matthewesses/ECE445_Team2_LabNotebooks/Notebooks/Shreya_Venkat/unnamed.jpeg

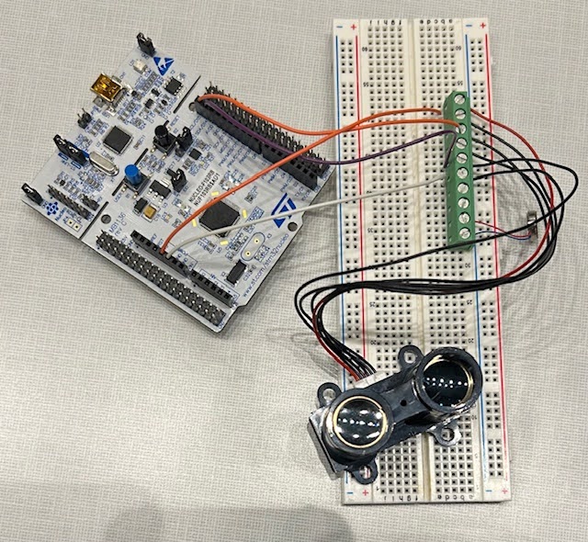
Notebooks/Shreya_Venkat/unnamed.jpeg
