matthewesses/ECE445_Team2_LabNotebooks/README.md

# ECE445 Team 2's Lab Notebooks
Lab Notebook repository for Team 2 for ECE 445 at UIUC
