matthewesses/ECE445_Team2_LabNotebooks/Boards/Initial Schematics/readme.txt

These schematics were the initial ones created by Varik and Matt
They contain (almost) every part that needs to be in the project in some capacity.
The voltage divider resistors that should be on the hall effect sensors are not here (yet).
