matthewesses/ECE445_Team2_LabNotebooks/Notebooks/Matthew_Esses/readme.md

# Engineering notebook

## 1/14-1/15 Project Ideation and Concept Development

### Initial Discussion with Mitchell
Before the class officially began, Mitchell and I discussed the primary aim of our project. We considered various factors such as the project's usefulness, the problem space it addresses, and the need for it to be enjoyable to work on.

### Exploration of Project Ideas
- **Remote Sensing Systems:** We both shared an interest in working with remote sensing systems like RaDAR and LiDAR.
- **Nintendo Switch JoyCon IR Camera Sensors:** Initially, I considered reverse engineering the Nintendo Switch JoyCon IR Camera Sensors for a wearable LiDAR system. However, due to challenges such as poor documentation, legal and ethical concerns, and the non-traditional problem space, this idea was abandoned.
- **ECE 445 Documentation Review:** Upon reviewing the documentation on the ECE 445 page, I realized the importance of the project being useful to someone, which led to a shift in focus.

### Final Project Concept: Wearable LiDAR for the Blind
- **LiDAR Principle:** LiDAR technology requires radial movement to generate a point cloud.
- **Initial Design Concept:**
  - Utilized a ring gear driven by two stepper motors.
  - Integrated LiDAR sensors into the ring gear, communicating wirelessly with a main computing unit.
- **Challenges and Abandonment:**
  - Power consumption concerns.
  - Feasibility issues.
  - Potential user discomfort.
  - Lack of practical usefulness.

### Conceptual Diagram
Wearable LiDAR Concept

## Engineering Notebook Entry - 1/16

### Inspiration from Natural Design
- **Radial Movement Concept:** Inspired by the arrangement of eyes on creatures' heads rather than their necks, I drew inspiration from propeller hats to achieve radial movement for the LiDAR system alongside a slip-ring.

### Sensor Range Consideration
- **NIR Range Selection:** Opted to develop a LiDAR sensor within the Near-Infrared (NIR) range instead of using an off-the-shelf solution. The choice was influenced by NIR's reduced vulnerability to solar noise due to the absorption properties of molecular oxygen and water vapor.

### Atmospheric Absorption Analysis
- **Reference [1]:** Explained the absorption of light by molecular oxygen and water vapor in the red, near-infrared, and mid-infrared regions.

Figure 3: Light Absorption Via the Atmosphere

### Collaboration and Guidance
- **Office Hours with Jason (Head Lab TA):** Discussed the project requirements for building a LiDAR sensor using a time-of-flight ASIC.
- **Recommendations:**
  - Use of the STM32F401 microcontroller.
  - Integration of a Hall Effect sensor to determine motor orientation and track RPM of the sensor motor.
- **Concept Sketch:** Provided a rough sketch of the sensor concept.

Concept Sketch

## 1/17

### Sensor Selection and Additional Features
- **Design Feasibility:** After discussions with professors, it was determined that designing our own sensor was not feasible, leading us to opt for an off-the-shelf solution.
- **Incorporation of Doppler Radar:** To enhance functionality, a Doppler Radar was added to provide data below eye-level, particularly for emergency collision prevention purposes.

### Project Research and Documentation
- **Review of Previous Projects:** Studied projects from previous years to gain insights and inspiration.
- **Faculty Consultations:** Addressed questions from professors to ensure project alignment and feasibility.
- **Submission of RFA:** Submitted the Request for Approval (RFA) after completing a rough sketch of the physical design, which was shared with the team.

### Design Enhancement and Communication
- **Physical Design Sketch:** Shared a rough sketch of the physical design with the team, detailing key components and layout.
- **CAD Modeling:** Created a professional CAD model for the design, documented in the design document.

### Functional Enhancements
- **Motor Intensity Control:** Planned to implement motor intensity control using haptic feedback and Pulse Width Modulation (PWM) techniques for enhanced user interaction.

## 1/18

### Meeting with team for first time
- Met with team for the first time on 1/18, explained more of the ideas verbally, got feedback, planned roles and ways forward

## 1/24

### LiDAR Sensor Testing
- **Data Acquisition:** Focused on obtaining readings from the LiDAR sensor.
- **Datasheet Reference:** Utilized a datasheet for the LiDAR sensor available within the class resources.
- **Team Collaboration:** Tested the LiDAR sensor on an Arduino development board as a team, verifying its accuracy and performance against the datasheet specifications.

### Exploration of Hall Effect Sensors
- **Research and Learning:** Delved into understanding the functionality of Hall Effect sensors.
- **Initial Progress:** Began designing a Hall Effect sensor array to determine the orientation of the LiDAR sensor and synchronize it with the haptic feedback motors.

### Productivity Challenges
- **Personal Impact:** Experienced a period of decreased productivity for several weeks going forward due to personal reasons.

### Ongoing Development
- **Hall Effect Sensor Array Design:** Continued work on designing the Hall Effect sensor array for angle detection of the LiDAR sensor and its integration with the haptic feedback motors.

### Next Steps
- **Resume Development:** Plan to resume full development activities and focus on completing the Hall Effect sensor array design and synchronization with motor control for the LiDAR system.

##  Death of DeMux 2/5

### DeMux death
- **Demultiplexer no longer used:** Partner Mitchell was strongly convinced using a demultiplexer to run PDM to a motor and using an ATMEGA328 was not viable and could not work. I strongly disagreed, but let it go because I was experiencing bad personal circumstances. Edit 4/29: in hindsight, terrible decision to let this go, partner Shreya took my side on this and it likely would have made the entire project more successful and we would have had next to no problems in programming due to more reliable documentation and course staff assistance for the ATMEGA. There were never any sources to back up the claim of it not working for the proposed design, but I digress.

## 2/12/24 Meeting 1 with Sanjana TA
### What was accomplished
- **Given Locker**
- **Able to order parts**
- **ordered parts**

## 2/19/24 Meeting 2 with Sanjana TA
### What was accomplished
- **Discussed design progress and BOM**

## 2/26/24 Meeting 3 with Sanjana TA
### What was accomplished
- **Meeting cancelled**

## 3/4 Meeting 4 with Sanjana TA
### What was accomplished
- **we need to work on the CAD, last TA meeting of note before 3/25**

## STM32F401 Programming and PCB Routing - 3/6-3/13

### STM32F401 Programming
- **Learning Phase:** Acquired knowledge for programming the STM32F401 microcontroller.
- **Circuit Enhancements:** Added an SWD header and Micro-USB connector to the circuit diagram for enhanced connectivity and programming capabilities.

### PCB Routing
- **Responsibility Assignment:** Took on the task of routing the PCB for the project.
- **Layer Consideration:** Ensured that reworking the microcontroller connections allowed for efficient routing on two layers.

### Team Collaboration and Quality Control
- **PCB Review:** Checked and verified the PCB design for any design violations, collaborating with team members Mitchell and Shreya.
- **Ordering Process:** Assisted in the order placement for the PCB board, handled by team member Shreya.

### Current Progress and Next Steps
- **Ongoing Work:** Waiting for completion of I2C integration with the STM32 dev board by Shreya to proceed with further physical design work.
- **Control Flow Mapping:** Mapped out the control flow for the control unit's programming, ensuring a clear understanding of the system's functionality.
- **Upcoming Tasks:** Deciding on off-board components for the half-wave rectifier and voltage divider for the Hall Effect sensors, focusing on low power consumption considerations.

### Pictures of circuit CAD
Pictures of circuit CAD


## 3/25 Meeting 5 with Sanjana TA
### What was accomplished
- **motioned to move accelerometer and we plan testing**

## 3/14-4/05 WAITING FOR THE PCB!!!

The PCB took a very long time to arrive. We decided on using either a stepper motor or the motor from ECE 110 at this time.

## 4/1 Meeting 6 with Sanjana TA
### What was accomplished
- **find back-up plans for if stuff does not work**

## 4/4 New scanning mechanism

### **Current Progress and Next Steps:** gave up on waiting and redesigned the drive train to be belt driven instead of purely gear driven to make the Hall-Effect module feasible. 3D printing first parts

# Engineering Notebook Entry - 4/7-4/10

## PCB Arrival and Troubleshooting

### PCB Delivery and Initial Issues
- **PCB Arrival:** Received the PCBs today.
- **Short Circuit Discovery:** Identified a short circuit between specific pins on the PCB.

### Troubleshooting and Resolution
- **Responsibility:** Tasked with locating and eliminating the short circuit to ensure proper board functionality.
- **Problem Areas:** Narrowed down potential locations of the short circuit to boot1 and boot0 pins, along with the 3V line connected to the buck converters.
- **Attempted non-destructive testing** Tried using a Nintendo switch joycon as an IR camera to read where the short was when I ran like 6W through the board, and it kinda went terribly and didnt show much due to the incident light was the only IR
- **Resolution Approach:** Drilled small holes into the PCB to pinpoint and eliminate the short circuit.
- **Success and Board Functionality:** After drilling, the board functioned as expected, allowing for continued progress and programming.

### Workload and Persistence
- **Time Investment:** Spent an entire night drilling into the boards to accurately identify and resolve the short circuit by myself.
- **Purpose of Drilling:** Ensured that the board could still be programmed and utilized for further iterations, even if similar issues were encountered in subsequent versions. I was also able to add destructive testing to my resume.

## Images of Drilled PCBs
- Drilled PCB 1
- Drilled PCB 2
- Drilled PCB 3

## Board Replacement and Progress - 4/11-4/13

### New Board Arrival
- **Replacement Boards:** Received the new set of boards, which did not have the short circuit issue found in the previous batch. Made final iteration of board and made sure they passed DRC.

### Personal Break and Decompression
- **Time Off:** Took a few days off to decompress and relax after the challenging experience of destructive testing being completely pointless. Did other coursework.

### Team Progress
- **Board Functionality:** The team successfully managed to get the new boards recognized by the development board and initiated programming tasks.

### Note on Progress
- **Alleged Programming Success:** While programming was reportedly successful, further verification and testing may be required to confirm full functionality and reliability.

## Drive Train and Scanning Mechanism Redesign -4/14-4/16

### Redesign Process
- **Drive Train and Scanning Mechanism:** Undertook another redesign iteration for improved functionality and performance. Group said part of it was too short.
- **3D Printing and Machining:** Utilized both 3D printing and manual machining through wood by hand drilling to create the redesigned components. Team lost access to MEB due to accidentally leaving a hot glue gun on.

### Hall Effect Module Holder Design
- **Design Task:** Created a holder specifically designed to accommodate the Hall Effect module, ensuring proper positioning and functionality within the system. 

### Progress Update
- **Completed Tasks:** Successfully completed the redesign of the drive train/scanning mechanism and the design of the Hall Effect module holder. completely assembled all parts.

### Next Steps
- **Integration:** Proceed with integrating the redesigned components into the overall system.
- **Testing:** Conduct initial testing to evaluate the performance and functionality of the redesigned drive train and scanning mechanism.

### First Iteration of Physical Assembly
Assembly 1 View 1
Assembly 1 View 2

## Drive Train and Scanning Mechanism Redesign (again) -4/18-4/20

### Redesign Details
- **Drive Train and Scanning Mechanism:** Conducted another round of redesigning to enhance performance and functionality (group hated it to my dismay)
- **Integration of Ball Bearing:** Incorporated a ball bearing into the design to reduce friction during the turning of the LiDAR system.
- **Space Accommodation for Hall Effect Module:** Ensured sufficient space and compatibility for the Hall Effect module within the redesigned components.

### Progress Update
- **Redesign Completion:** Successfully completed the redesign of the drive train/scanning mechanism, incorporating the ball bearing and accommodating space for the Hall Effect module.

### Next Steps
- **Integration Testing:** 3-D print models and make full assembly. Find a different place to 3-D print parts.

### CAD Assebly
Cad Assembly 2 View 1
Cad Assembly 2 View 2

## 3D Printing and Exam Day - 4/21-4/22

### 3D Printing Tasks
- **Part Production:** Utilized 3D printing technology to fabricate parts required for the project's assembly.

### Academic Commitment
- **ECE 434 Exam:** Had an exam for ECE 434, which required focus and preparation, leading to limited time available for completing the assembly.

### Progress Update
- **Part Production:** Successfully completed the 3D printing tasks, generating the necessary components for the project.

### Next Steps
- **Assembly Completion:** Plan to resume work and complete the assembly of the project once academic commitments, such as exams, are successfully addressed.

### Partial 3D prints
Partial 3D prints

## Physical Assembly Success and Role Reflection - 4/23

### Seeing-Eye-Hat Assembly
- **Completion:** Successfully finished the physical assembly for the seeing-eye-hat project.
- **First-Time Success:** The assembled project worked on the first try, indicating successful implementation.

### Role Reflection
- **Mechanical Engineering Contributions:** Recognized that my contributions to the project's physical assembly were more aligned with mechanical engineering principles rather than electrical engineering. Felt sad about it honestly.

### Group Challenges
- **PCB Issues:** The group encountered persistent challenges with the PCB, leading to difficulties in getting it to work.
- **Acceptance of Setbacks:** Accepted the reality of not achieving PCB-related milestones due to personal mistakes and challenges with supply chains.

### Completed physical assembly and project
Complete Assembly 2 View 1
Comblete Assembly 2 View 2

## PCB Challenges and Acceptance of Setbacks - 4/24

### PCB Return and Non-Functionality
- **PCB Parts Returned:** The parts for the PCB were returned to the sender due to ongoing issues.
- **Lack of Success:** Despite efforts, none of the PCB attempts yielded functional results.
- **Acknowledgement of Challenges:** Accepted the situation where personal mistakes and external factors, such as supply chain issues, hindered progress.

### Adaptation and Resilience
- **Learning Experience:** Viewed the setbacks as learning opportunities to improve processes and mitigate future challenges.
- **Resilience:** Maintained a positive outlook despite the setbacks and continued to focus on other aspects of the project.
### Bitter Defeat at the hands of USPS
Bitter Defeat at the hands of USPS
