matthewesses/ECE445_Team2_LabNotebooks/Models/gearattempt1 v3.stl

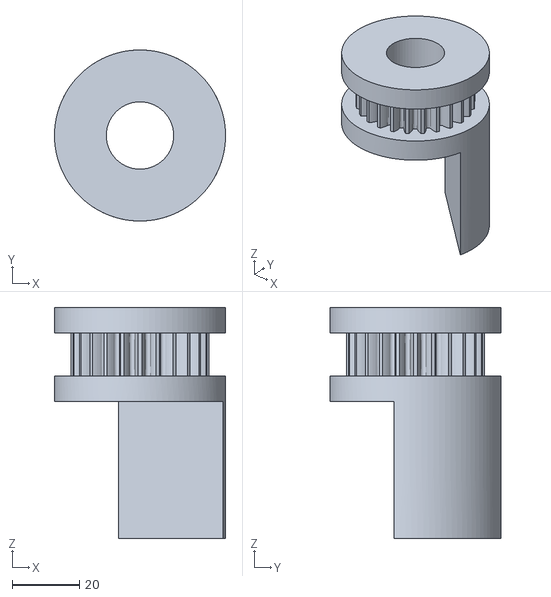
[picture p13: CAD file, 2024-04-08]
Models/gearattempt1 v3.stl
50.8 x 50.8 x 68.6
