matthewesses/ECE445_Team2_LabNotebooks/Models/geararoundmotor.stl

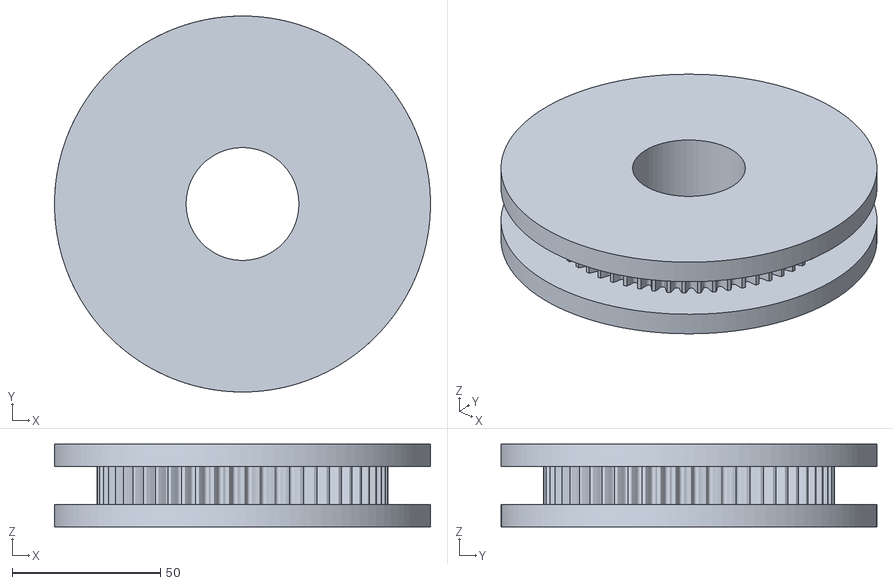
[picture p14: CAD file, 2024-04-08]
Models/geararoundmotor.stl
127.0 x 127.0 x 27.9
