matthewesses/ECE445_Team2_LabNotebooks/Boards/Power Board/Power_Board.kicad_pcb

## KiCad design Boards/Power Board/Power_Board.kicad_pcb (2024-04-09)

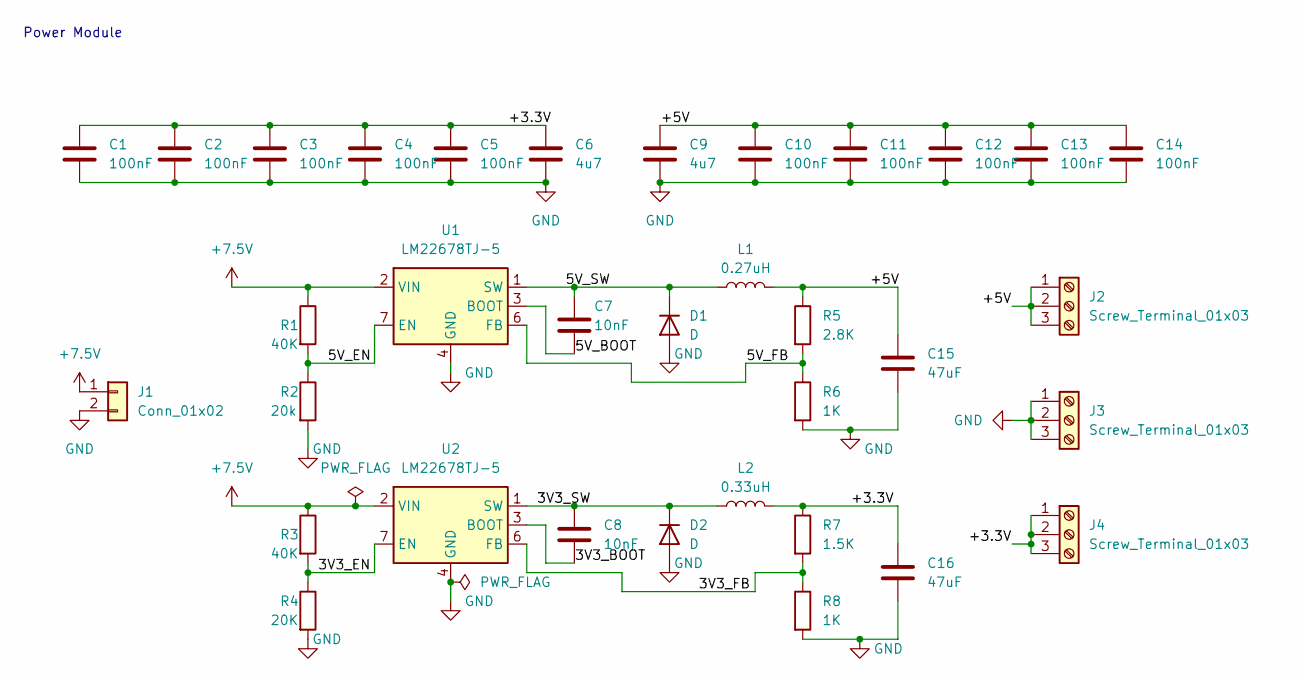
[picture p15: schematic Power_Board.kicad_sch]

Parts:
C1, C2, C3, C4, C5, C10, C11, C12, C13, C14: 100nF; C_0805_2012Metric_Pad1.18x1.45mm_HandSolder
C6, C9: 4u7; C_0805_2012Metric_Pad1.18x1.45mm_HandSolder
C7, C8: 10nF; C_0805_2012Metric_Pad1.18x1.45mm_HandSolder
C15, C16: 47uF; C_0805_2012Metric_Pad1.18x1.45mm_HandSolder
D1, D2: D; D_1210_3225Metric_Pad1.42x2.65mm_HandSolder
J1: Conn_01x02; AMASS_XT60-M_1x02_P7.20mm_Vertical
J2, J3, J4: Screw_Terminal_01x03; PinSocket_1x03_P2.54mm_Vertical
L1: 0.27uH; L_1210_3225Metric
L2: 0.33uH; L_1210_3225Metric
R1, R3: 40K; R_0805_2012Metric_Pad1.20x1.40mm_HandSolder
R2: 20k; R_0805_2012Metric_Pad1.20x1.40mm_HandSolder
R4: 20K; R_0805_2012Metric_Pad1.20x1.40mm_HandSolder
R5: 2.8K; R_0805_2012Metric_Pad1.20x1.40mm_HandSolder
R6, R8: 1K; R_0805_2012Metric_Pad1.20x1.40mm_HandSolder
R7: 1.5K; R_0805_2012Metric_Pad1.20x1.40mm_HandSolder
U1, U2: LM22678TJ-5; TO-263-7_TabPin8

Connections:
+7.5V: J1.1, R1.1, R3.1, U1.2 (VIN), U2.2 (VIN)
/3V3_BOOT: C8.2, U2.3 (BOOT)
/3V3_EN: R3.2, R4.1, U2.7 (EN)
/3V3_FB: R7.2, R8.1, U2.6 (FB)
/3V3_SW: C8.1, D2.1 (K), L2.1, U2.1 (SW)
/5V_BOOT: C7.2, U1.3 (BOOT)
/5V_EN: R1.2, R2.1, U1.7 (EN)
/5V_FB: R5.2, R6.1, U1.6 (FB)
/5V_SW: C7.1, D1.1 (K), L1.1, U1.1 (SW)
/+3.3V: C1.1, C2.1, C3.1, C4.1, C5.1, C6.1, C16.1, J4.1, J4.2, J4.3, L2.2, R7.1
/+5V: C9.1, C10.1, C11.1, C12.1, C13.1, C14.1, C15.1, J2.1, J2.2, J2.3, L1.2, R5.1
GND: C1.2, C2.2, C3.2, C4.2, C5.2, C6.2, C9.2, C10.2, C11.2, C12.2, C13.2, C14.2, C15.2, C16.2, D1.2 (A), D2.2 (A), J1.2, J3.1, J3.2, J3.3, R2.2, R4.2, R6.2, R8.2, U1.4 (GND), U1.8 (GND), U2.4 (GND), U2.8 (GND)

Notes on the sheet:
Power Module

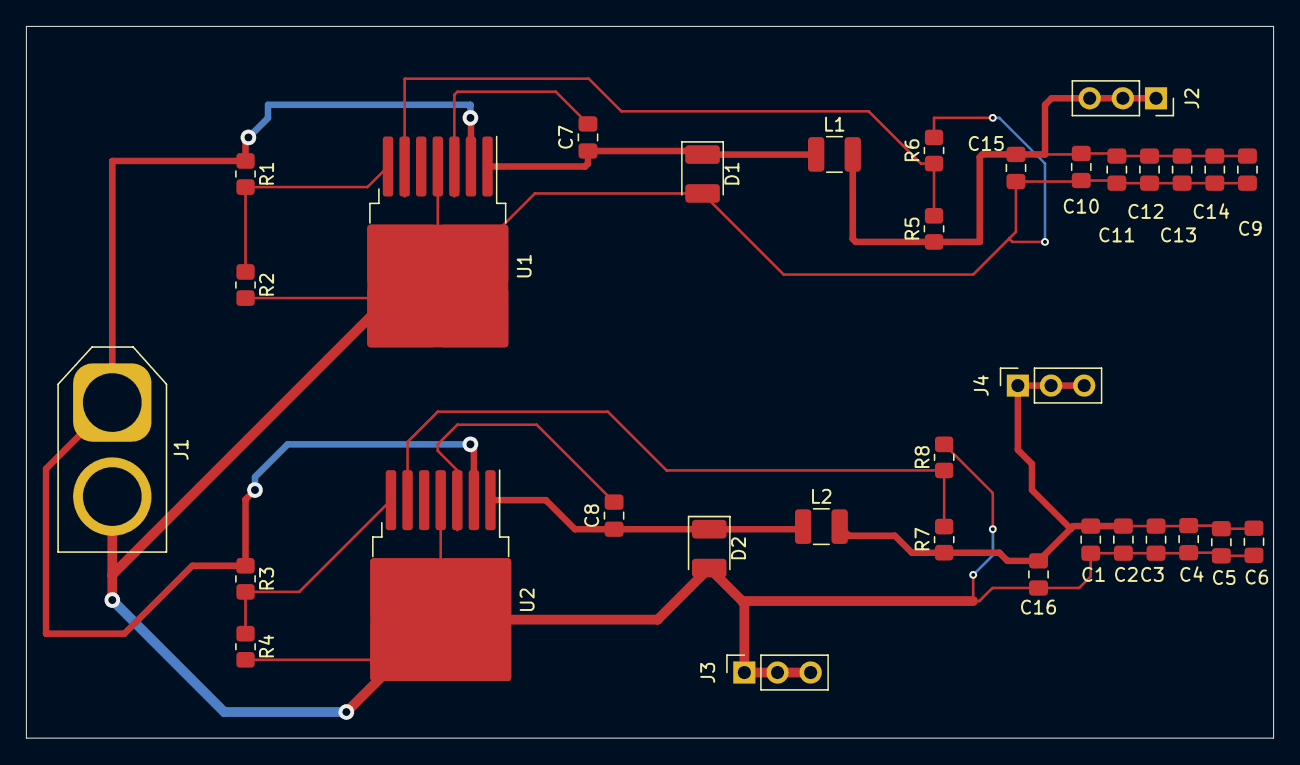
[picture p16: board Power_Board.kicad_pcb from above]

Board: 2 copper layers, 95.5 x 54.5 mm, 34 parts (0 on the bottom side), 12 nets.
