matthewesses/ECE445_Team2_LabNotebooks/Boards/Control Unit/ECE 445 Round 5 PCB.kicad_pcb

## KiCad design Boards/Control Unit/ECE 445 Round 5 PCB.kicad_pcb (2024-04-09)

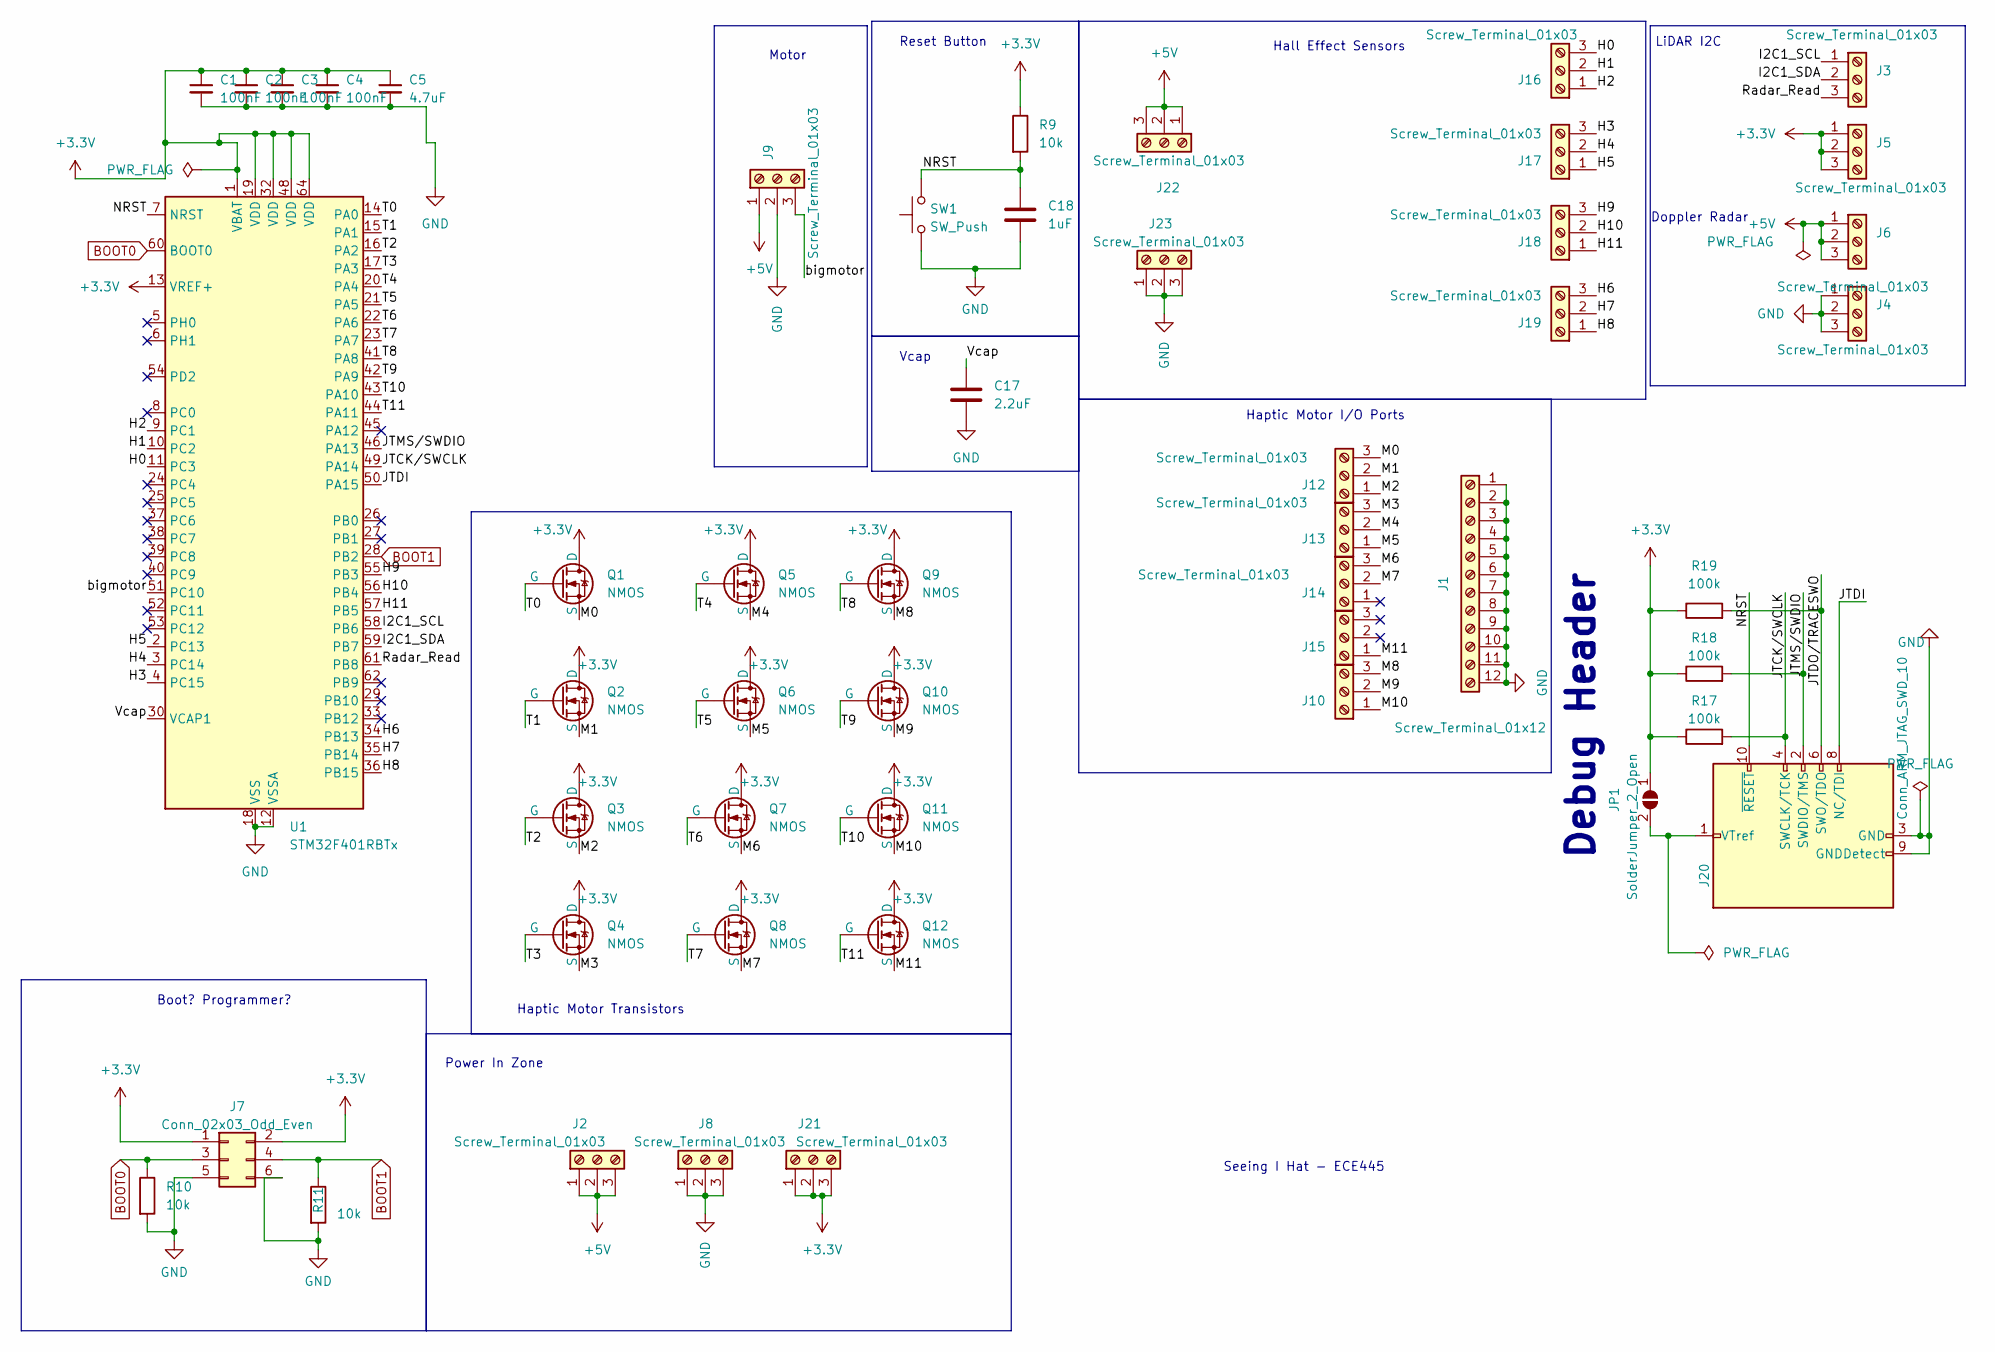
[picture p17: schematic ECE 445 Round 5 PCB.kicad_sch]

Parts:
C1, C2, C3, C4: 100nF; C_0805_2012Metric_Pad1.18x1.45mm_HandSolder
C5: 4.7uF; C_0805_2012Metric_Pad1.18x1.45mm_HandSolder
C17: 2.2uF; C_0805_2012Metric_Pad1.18x1.45mm_HandSolder
C18: 1uF; C_0805_2012Metric_Pad1.18x1.45mm_HandSolder
J1: Screw_Terminal_01x12; PinSocket_1x12_P2.54mm_Vertical
J2, J3, J4, J5, J6, J8, J9, J10, J12, J13, J14, J15, J16, J17, J18, J19, J21, J22, J23: Screw_Terminal_01x03; PinSocket_1x03_P2.54mm_Vertical
J7: Conn_02x03_Odd_Even; PinSocket_2x03_P2.54mm_Vertical
J20: Conn_ARM_JTAG_SWD_10; IDC-Header_2x05_P2.54mm_Vertical
JP1: SolderJumper_2_Open; SolderJumper-2_P1.3mm_Open_TrianglePad1.0x1.5mm
Q1, Q2, Q3, Q4, Q5, Q6, Q7, Q8, Q9, Q10, Q11, Q12: NMOS; SOT-23-3
R9, R10, R11: 10k; R_0805_2012Metric_Pad1.20x1.40mm_HandSolder
R17, R18, R19: 100k; R_0805_2012Metric_Pad1.20x1.40mm_HandSolder
SW1: SW_Push; SW_SPST_B3S-1000
U1: STM32F401RBTx; LQFP-64_10x10mm_P0.5mm

Connections:
+3.3V: C1.1, C2.1, C3.1, C4.1, C5.1, J5.1, J5.2, J5.3, J7.1, J7.2, J21.1, J21.2, J21.3, JP1.1 (A), Q1.1 (D), Q2.1 (D), Q3.1 (D), Q4.1 (D), Q5.1 (D), Q6.1 (D), Q7.1 (D), Q8.1 (D), Q9.1 (D), Q10.1 (D), Q11.1 (D), Q12.1 (D), R9.1, R17.1, R18.1, R19.1, U1.1 (VBAT), U1.13 (VREF+), U1.19 (VDD), U1.32 (VDD), U1.48 (VDD), U1.64 (VDD)
+5V: J2.1, J2.2, J2.3, J6.1, J6.2, J6.3, J9.1, J22.1, J22.2, J22.3
/H0: J16.3, U1.11 (PC3)
/H1: J16.2, U1.10 (PC2)
/H2: J16.1, U1.9 (PC1)
/H3: J17.3, U1.4 (PC15)
/H4: J17.2, U1.3 (PC14)
/H5: J17.1, U1.2 (PC13)
/H6: J19.3, U1.34 (PB13)
/H7: J19.2, U1.35 (PB14)
/H8: J19.1, U1.36 (PB15)
/H9: J18.3, U1.55 (PB3)
/H10: J18.2, U1.56 (PB4)
/H11: J18.1, U1.57 (PB5)
/I2C1_SCL: J3.1, U1.58 (PB6)
/I2C1_SDA: J3.2, U1.59 (PB7)
/JTCK/SWCLK: J20.4 (SWCLK/TCK), R17.2, U1.49 (PA14)
/JTDI: J20.8 (NC/TDI), U1.50 (PA15)
/JTDO/TRACESWO: J20.6 (SWO/TDO), R19.2
/JTMS/SWDIO: J20.2 (SWDIO/TMS), R18.2, U1.46 (PA13)
/M0: J12.3, Q1.3 (S)
/M1: J12.2, Q2.3 (S)
/M2: J12.1, Q3.3 (S)
/M3: J13.3, Q4.3 (S)
/M4: J13.2, Q5.3 (S)
/M5: J13.1, Q6.3 (S)
/M6: J14.3, Q7.3 (S)
/M7: J14.2, Q8.3 (S)
/M8: J10.3, Q9.3 (S)
/M9: J10.2, Q10.3 (S)
/M10: J10.1, Q11.3 (S)
/M11: J15.1, Q12.3 (S)
/NRST: C18.1, J20.10 (~RESET), R9.2, SW1.2, U1.7 (NRST)
/Radar_Read: J3.3, U1.61 (PB8)
/T0: Q1.2 (G), U1.14 (PA0)
/T1: Q2.2 (G), U1.15 (PA1)
/T2: Q3.2 (G), U1.16 (PA2)
/T3: Q4.2 (G), U1.17 (PA3)
/T4: Q5.2 (G), U1.20 (PA4)
/T5: Q6.2 (G), U1.21 (PA5)
/T6: Q7.2 (G), U1.22 (PA6)
/T7: Q8.2 (G), U1.23 (PA7)
/T8: Q9.2 (G), U1.41 (PA8)
/T9: Q10.2 (G), U1.42 (PA9)
/T10: Q11.2 (G), U1.43 (PA10)
/T11: Q12.2 (G), U1.44 (PA11)
/Vcap: C17.1, U1.30 (VCAP1)
/bigmotor: J9.3, U1.51 (PC10)
BOOT0: J7.3, R10.1, U1.60 (BOOT0)
BOOT1: J7.4, R11.1, U1.28 (PB2)
GND: C1.2, C2.2, C3.2, C4.2, C5.2, C17.2, C18.2, J1.1, J1.2, J1.3, J1.4, J1.5, J1.6, J1.7, J1.8, J1.9, J1.10, J1.11, J1.12, J4.1, J4.2, J4.3, J7.5, J7.6, J8.1, J8.2, J8.3, J9.2, J20.3 (GND), J20.5 (GND), J20.9 (GNDDetect), J23.1, J23.2, J23.3, R10.2, R11.2, SW1.1, U1.12 (VSSA), U1.18 (VSS), U1.31 (VSS), U1.47 (VSS), U1.63 (VSS)
unnamed: J20.1 (VTref), JP1.2 (B)

Notes on the sheet:
Boot? Programmer?
Seeing I Hat - ECE445
Haptic Motor I/O Ports
Debug Header
Motor
Doppler Radar
Reset Button
LiDAR I2C
Power In Zone
Vcap
Hall Effect Sensors
Haptic Motor Transistors

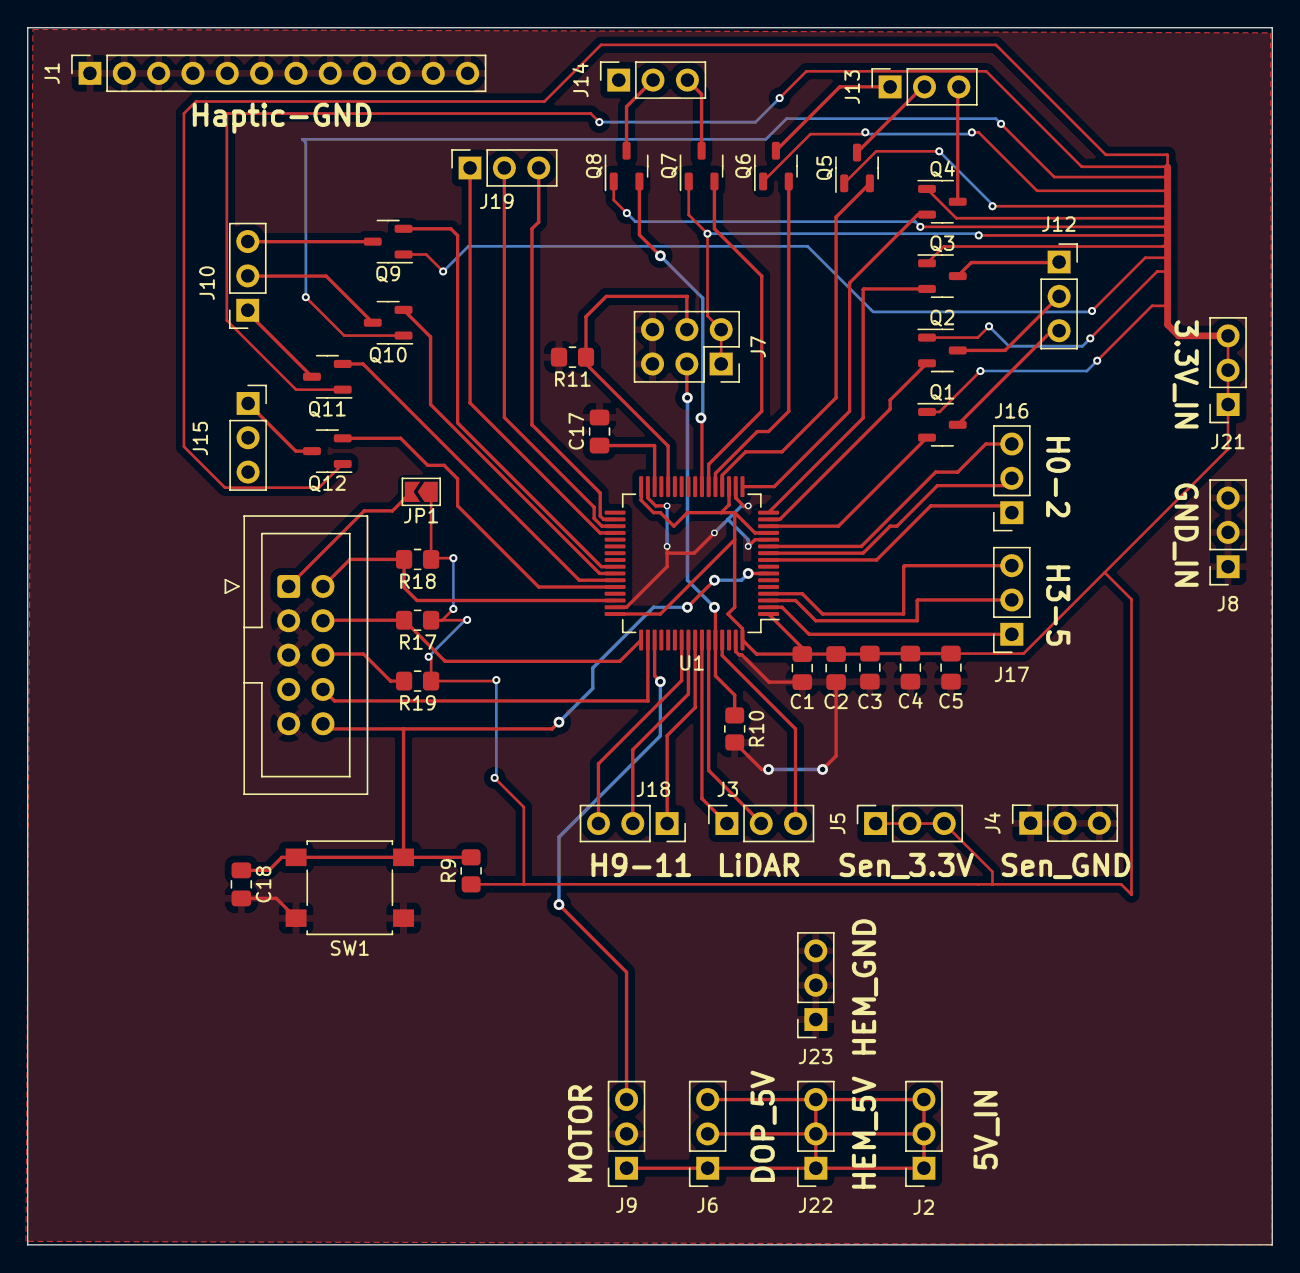
[picture p18: board ECE 445 Round 5 PCB.kicad_pcb from above]

Board: 2 copper layers, 92.1 x 90.0 mm, 50 parts (0 on the bottom side), 52 nets.
