matthewesses/ECE445_Team2_LabNotebooks/Boards/Round 2 PCB/PCB_R1.kicad_pcb

## KiCad design Boards/Round 2 PCB/PCB_R1.kicad_pcb (2024-03-19)

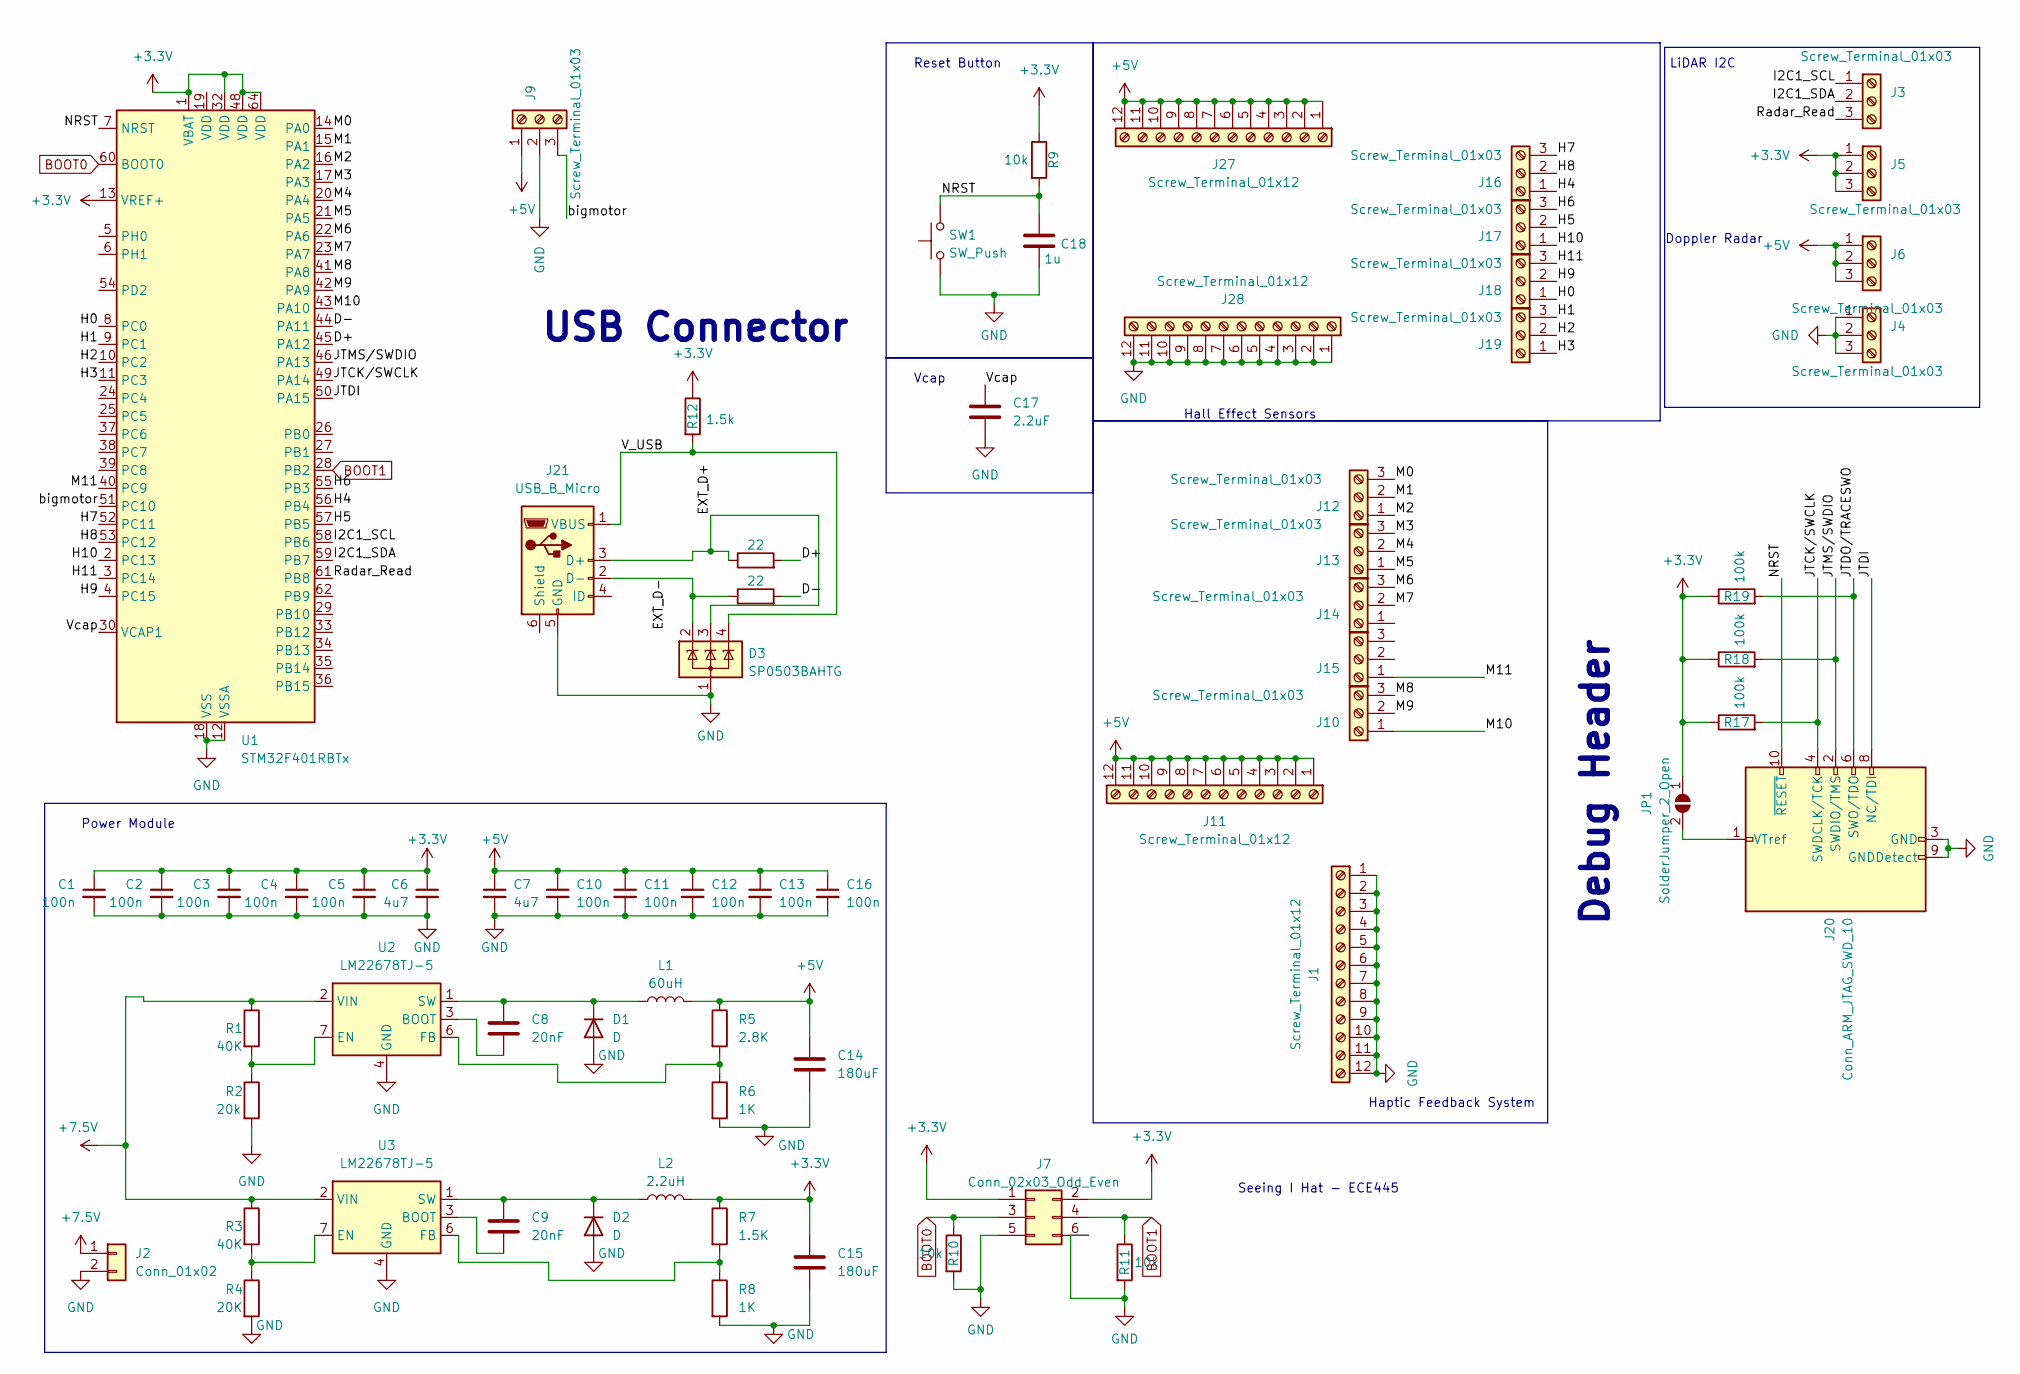
[picture p19: schematic PCB_R1.kicad_sch]

Parts:
C1, C2, C3, C4, C5, C10, C11, C12, C13, C16: 100n; C_0805_2012Metric_Pad1.18x1.45mm_HandSolder; LCSC Part # C1525
C6, C7: 4u7; C_0805_2012Metric_Pad1.18x1.45mm_HandSolder; LCSC Part # C19666
C8, C9: 20nF; C_0805_2012Metric_Pad1.18x1.45mm_HandSolder
C14, C15: 180uF; C_0805_2012Metric_Pad1.18x1.45mm_HandSolder
C17: 2.2uF; C_0805_2012Metric_Pad1.18x1.45mm_HandSolder
C18: 1u; C_0805_2012Metric_Pad1.18x1.45mm_HandSolder
D1, D2: D; D_1210_3225Metric_Pad1.42x2.65mm_HandSolder
D3: SP0503BAHTG; SOT-143
J1, J11, J27, J28: Screw_Terminal_01x12; PinSocket_1x12_P2.54mm_Vertical
J2: Conn_01x02; AMASS_XT60-M_1x02_P7.20mm_Vertical
J3, J4, J5, J6, J9, J10, J12, J13, J14, J15, J16, J17, J18, J19: Screw_Terminal_01x03; PinSocket_1x03_P2.54mm_Vertical
J7: Conn_02x03_Odd_Even; PinSocket_2x03_P2.54mm_Vertical
J20: Conn_ARM_JTAG_SWD_10; IDC-Header_2x05_P2.54mm_Vertical
J21: USB_B_Micro; USB_Micro-B_Molex_47346-0001
JP1: SolderJumper_2_Open; SolderJumper-2_P1.3mm_Open_TrianglePad1.0x1.5mm
L1: 60uH; L_1210_3225Metric
L2: 2.2uH; L_1210_3225Metric
R1, R3: 40K; R_0805_2012Metric_Pad1.20x1.40mm_HandSolder
R2: 20k; R_0805_2012Metric_Pad1.20x1.40mm_HandSolder
R4: 20K; R_0805_2012Metric_Pad1.20x1.40mm_HandSolder
R5: 2.8K; R_0805_2012Metric_Pad1.20x1.40mm_HandSolder
R6, R8: 1K; R_0805_2012Metric_Pad1.20x1.40mm_HandSolder
R7: 1.5K; R_0805_2012Metric_Pad1.20x1.40mm_HandSolder
R9, R10, R11: 10k; R_0805_2012Metric_Pad1.20x1.40mm_HandSolder
R12: 1.5k; R_0805_2012Metric
R13, R15: 22; R_0603_1608Metric
R17, R18, R19: 100k; R_0805_2012Metric_Pad1.20x1.40mm_HandSolder
SW1: SW_Push; SW_SPST_B3S-1000
U1: STM32F401RBTx; LQFP-64_10x10mm_P0.5mm
U2, U3: LM22678TJ-5; TO-263-7_TabPin8

Connections:
+7.5V: J2.1, R1.1, R3.1, U2.2 (VIN), U3.2 (VIN)
/D+: R13.2, U1.45 (PA12)
/D-: R15.2, U1.44 (PA11)
/EXT_D+: D3.3 (K), J21.3 (D+), R13.1
/EXT_D-: D3.2 (K), J21.2 (D-), R15.1
/H0: J18.1, U1.8 (PC0)
/H1: J19.3, U1.9 (PC1)
/H2: J19.2, U1.10 (PC2)
/H3: J19.1, U1.11 (PC3)
/H4: J16.1, U1.56 (PB4)
/H5: J17.2, U1.57 (PB5)
/H6: J17.3, U1.55 (PB3)
/H7: J16.3, U1.52 (PC11)
/H8: J16.2, U1.53 (PC12)
/H9: J18.2, U1.4 (PC15)
/H10: J17.1, U1.2 (PC13)
/H11: J18.3, U1.3 (PC14)
/I2C1_SCL: J3.1, U1.58 (PB6)
/I2C1_SDA: J3.2, U1.59 (PB7)
/JTCK/SWCLK: J20.4 (SWDCLK/TCK), R17.2, U1.49 (PA14)
/JTDI: J20.8 (NC/TDI), U1.50 (PA15)
/JTDO/TRACESWO: J20.6 (SWO/TDO), R19.2
/JTMS/SWDIO: J20.2 (SWDIO/TMS), R18.2, U1.46 (PA13)
/M0: J12.3, U1.14 (PA0)
/M1: J12.2, U1.15 (PA1)
/M2: J12.1, U1.16 (PA2)
/M3: J13.3, U1.17 (PA3)
/M4: J13.2, U1.20 (PA4)
/M5: J13.1, U1.21 (PA5)
/M6: J14.3, U1.22 (PA6)
/M7: J14.2, U1.23 (PA7)
/M8: J10.3, U1.41 (PA8)
/M9: J10.2, U1.42 (PA9)
/M10: J10.1, U1.43 (PA10)
/M11: J15.1, U1.40 (PC9)
/NRST: C18.1, J20.10 (~RESET), R9.2, SW1.2, U1.7 (NRST)
/Radar_Read: J3.3, U1.61 (PB8)
/V_USB: D3.4 (K), J21.1 (VBUS), R12.2
/Vcap: C17.1, U1.30 (VCAP1)
/bigmotor: J9.3, U1.51 (PC10)
BOOT0: J7.3, R10.1, U1.60 (BOOT0)
BOOT1: J7.4, R11.1, U1.28 (PB2)
GND: C1.2, C2.2, C3.2, C4.2, C5.2, C6.2, C7.2, C10.2, C11.2, C12.2, C13.2, C14.2, C15.2, C16.2, C17.2, C18.2, D1.2 (A), D2.2 (A), D3.1 (A), J1.1, J1.2, J1.3, J1.4, J1.5, J1.6, J1.7, J1.8, J1.9, J1.10, J1.11, J1.12, J2.2, J4.1, J4.2, J4.3, J7.5, J7.6, J9.2, J20.3 (GND), J20.5 (GND), J20.9 (GNDDetect), J21.5 (GND), J28.1, J28.2, J28.3, J28.4, J28.5, J28.6, J28.7, J28.8, J28.9, J28.10, J28.11, J28.12, R2.2, R4.2, R6.2, R8.2, R10.2, R11.2, SW1.1, U1.12 (VSSA), U1.18 (VSS), U1.31 (VSS), U1.47 (VSS), U1.63 (VSS), U2.4 (GND), U2.8 (GND), U3.4 (GND), U3.8 (GND)
unnamed: C8.1, D1.1 (K), L1.1, U2.1 (SW)
unnamed: C9.1, D2.1 (K), L2.1, U3.1 (SW)
unnamed: J20.1 (VTref), JP1.2 (B)
unnamed: C8.2, U2.3 (BOOT)
unnamed: R1.2, R2.1, U2.7 (EN)
unnamed: R5.2, R6.1, U2.6 (FB)
unnamed: C9.2, U3.3 (BOOT)
unnamed: R3.2, R4.1, U3.7 (EN)
unnamed: R7.2, R8.1, U3.6 (FB)

Notes on the sheet:
Seeing I Hat - ECE445
Debug Header
Power Module
Haptic Feedback System
Doppler Radar
Reset Button
USB Connector
LiDAR I2C
Vcap
Hall Effect Sensors

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
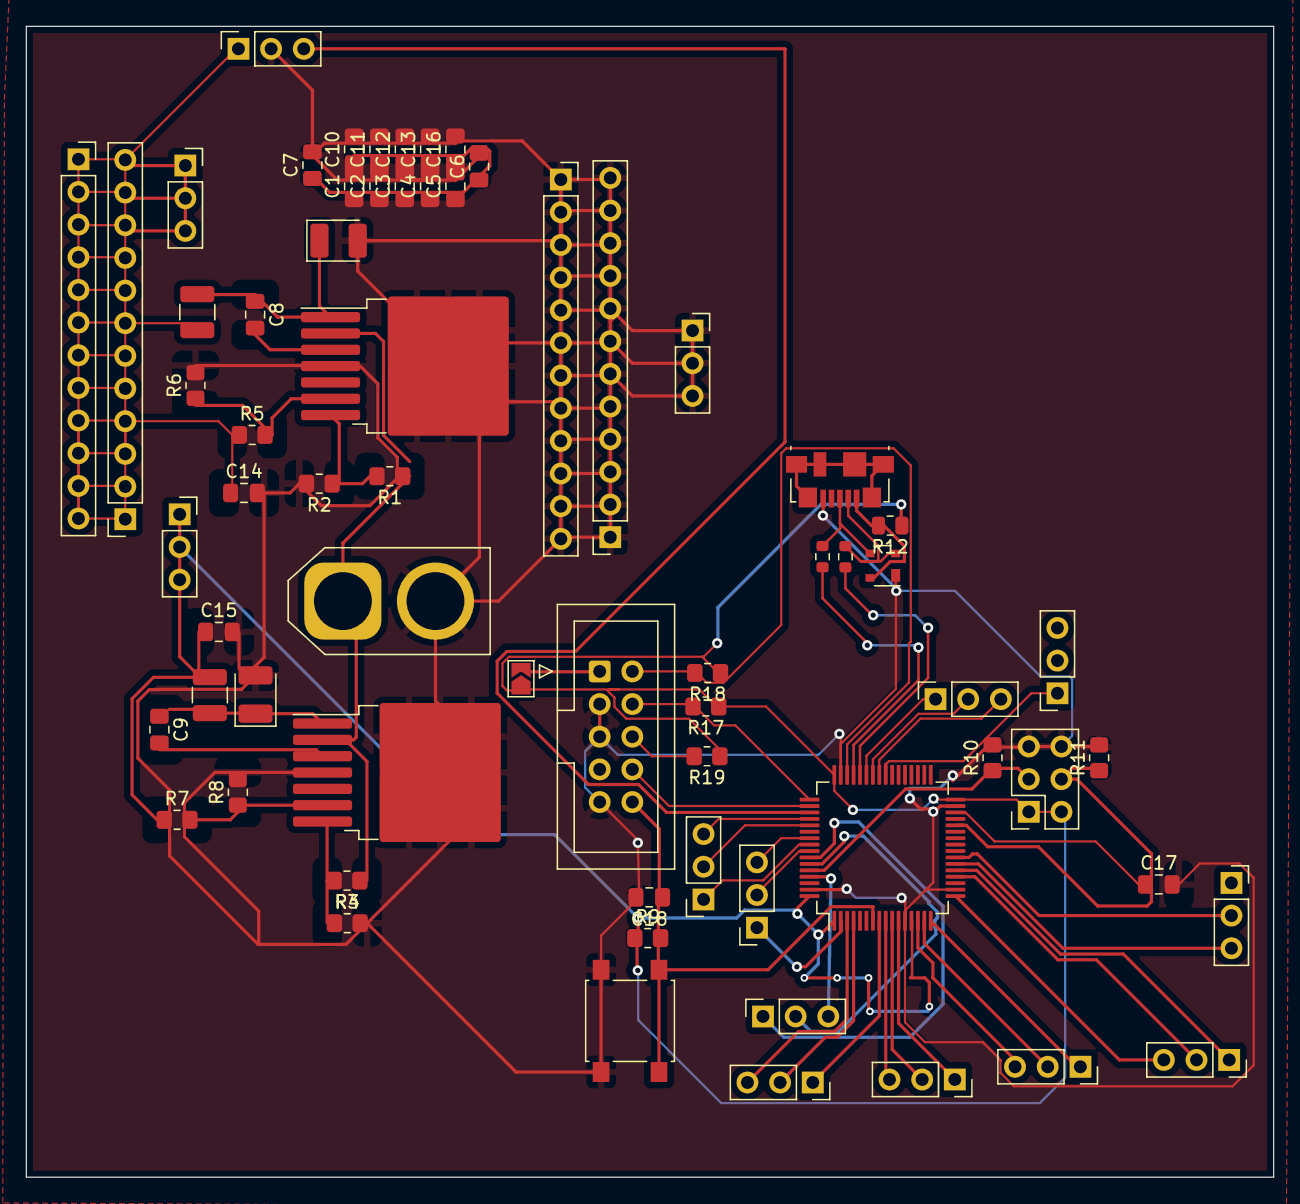
[picture p20: board PCB_R1.kicad_pcb from above]

Board: 2 copper layers, 97.0 x 89.5 mm, 67 parts (0 on the bottom side), 55 nets.
