matthewesses/ECE445_Team2_LabNotebooks/(commit log)

2024-03-17 Moving PCB version control to github
    That got ugly, we now have a folder for the complete schematic, and the round 1 PCB Files.
    [445PCB.kicad_sch, 445_Bus_Version_ft_Programming.kicad_sch, PCB_R1.kicad_pcb, PCB_R1.kicad_sch]
2024-03-17 Power System Update
    added component values to the power system, and fixed ground nets
    [PCB_R1.kicad_sch]
2024-03-17 Inductor update
    oops, I forgot the inductor values again
    [PCB_R1.kicad_sch]
2024-03-18 Misc updates from 3/17/24
    Touched up a few really minor things while I was doing the parts list
    [PCB_R1.kicad_sch]
2024-03-18 PCB Design contraints
    Updated and tested width and clearene constraints and everything was ok, one unconnected thing. Footprints not updated
    [PCB_R1.kicad_pcb]
2024-03-18 fixed PCB contraints and re-routed something that broke
    yea, that
    [PCB_R1.kicad_pcb]
2024-03-18 R1 - no builder errors
    woot woot
    [PCB_R1-B_Cu.gbr, PCB_R1-B_Mask.gbr, PCB_R1-B_Paste.gbr, PCB_R1-B_Silkscreen.gbr, PCB_R1-Edge_Cuts.gbr, PCB_R1-F_Cu.gbr, PCB_R1-F_Mask.gbr, PCB_R1-F_Paste.gbr]
2024-03-18 r1 SMD footprint updates
    changed component footprints on the board and schematic to use free smd components
    [PCB_R1.kicad_pcb, PCB_R1.kicad_sch]
2024-03-19 Create I2C Communication Notes
2024-03-19 Resistor 0805 update
    all resistors and capacitors are 0805 now, thanks Dad
    [PCB_R1.kicad_pcb, PCB_R1.kicad_sch]
2024-03-21 Round 2 Init
    ROUND 2, START!
    [PCB_R1-B_Cu.gbr, PCB_R1-B_Mask.gbr, PCB_R1-B_Paste.gbr, PCB_R1-B_Silkscreen.gbr, PCB_R1-Edge_Cuts.gbr, PCB_R1-F_Cu.gbr, PCB_R1-F_Mask.gbr, PCB_R1-F_Paste.gbr]
2024-03-23 ground layer test
    placed all transistors, about to delete all ground connections
    [PCB_R2.kicad_pcb, PCB_R2.kicad_sch]
2024-03-23 transistor routing
    3.3V pins on all transistors are routed. Should increase net width of 3.3V bus
    [PCB_R2.kicad_pcb]
2024-03-23 error handeling
    fixed all errors after adding transistors and general cleanup
    [PCB_R2.kicad_pcb]
2024-03-23 power bus width update
    Updated power bus width going to each of the motors to reduce board heating
    [PCB_R2.kicad_pcb]
2024-03-24 adding notes on I2C
2024-03-25 placeholder file for i2c
2024-03-25 replace stm32 i2c file
    [i2cTest_stm32.ino]
2024-03-25 add new i2c file
2024-03-27 debugging program from adafruit (checks for lidar)
2024-03-27 HVPS Update
    changed HVPS components to increase maximum current from 0.5A to 1A
    [PCB_R2.kicad_sch]
2024-04-09 Power Board Seperate Edition
    I wanna go to bed
    [PCB_R1-B_Cu.gbr, PCB_R1-B_Mask.gbr, PCB_R1-B_Paste.gbr, PCB_R1-B_Silkscreen.gbr, PCB_R1-Edge_Cuts.gbr, PCB_R1-F_Cu.gbr, PCB_R1-F_Mask.gbr, PCB_R1-F_Paste.gbr]
2024-04-09 current version of separate control unit
    [ECE 445 Round 5 PCB.kicad_pcb, ECE 445 Round 5 PCB.kicad_sch]
2024-04-09 power board connectors and ERC changes
    reeeeeeeeeeeeeeeeeeeee
    [Power_Board.kicad_pcb, Power_Board.kicad_sch]
2024-04-09 control unit ERC Changes part 1
    resistors need changes
    [ECE 445 Round 5 PCB.kicad_sch]
2024-04-09 control unit pt2 all errors/warnings fixed
    [ECE 445 Round 5 PCB.kicad_sch]
2024-04-09 added pwr_flags to resolve errors
    [Power_Board.kicad_sch]
2024-04-09 removed extranious 5v power buses
    hall effect module is pretty nice
    [ECE 445 Round 5 PCB.kicad_pcb, ECE 445 Round 5 PCB.kicad_sch]
2024-04-09 routed except gnd and vcc
    that was rough
    [ECE 445 Round 5 PCB.kicad_pcb, ECE 445 Round 5 PCB.kicad_sch]
2024-04-09 power routing example
    oop
    [ECE 445 Round 5 PCB.kicad_pcb]
2024-04-09 current control unit
    [ECE 445 Round 5 PCB.kicad_pcb]
2024-04-09 didnt save,
    sad
    [ECE 445 Round 5 PCB.kicad_pcb]
2024-04-09 power system size decrease
    a
    [Power_Board.kicad_pcb]
2024-04-13 first draft of code for hall effect sensors on pcb
2024-04-13 stencil hall effect code devboard
2024-04-13 full code drafts for pcb and devboard
2024-04-16 added pin assignments
2024-04-16 added pin assignments for hall and motor
2024-04-22 code w/stepper motor and one hall effect
2024-04-26 added doppler w/print
2024-04-28 design sections, power, haptic, scanning
    progess
2024-04-28 BOM and Power Details
    stuff
